weynechen/flickersensor/Doc/flicker_sensor.pdf

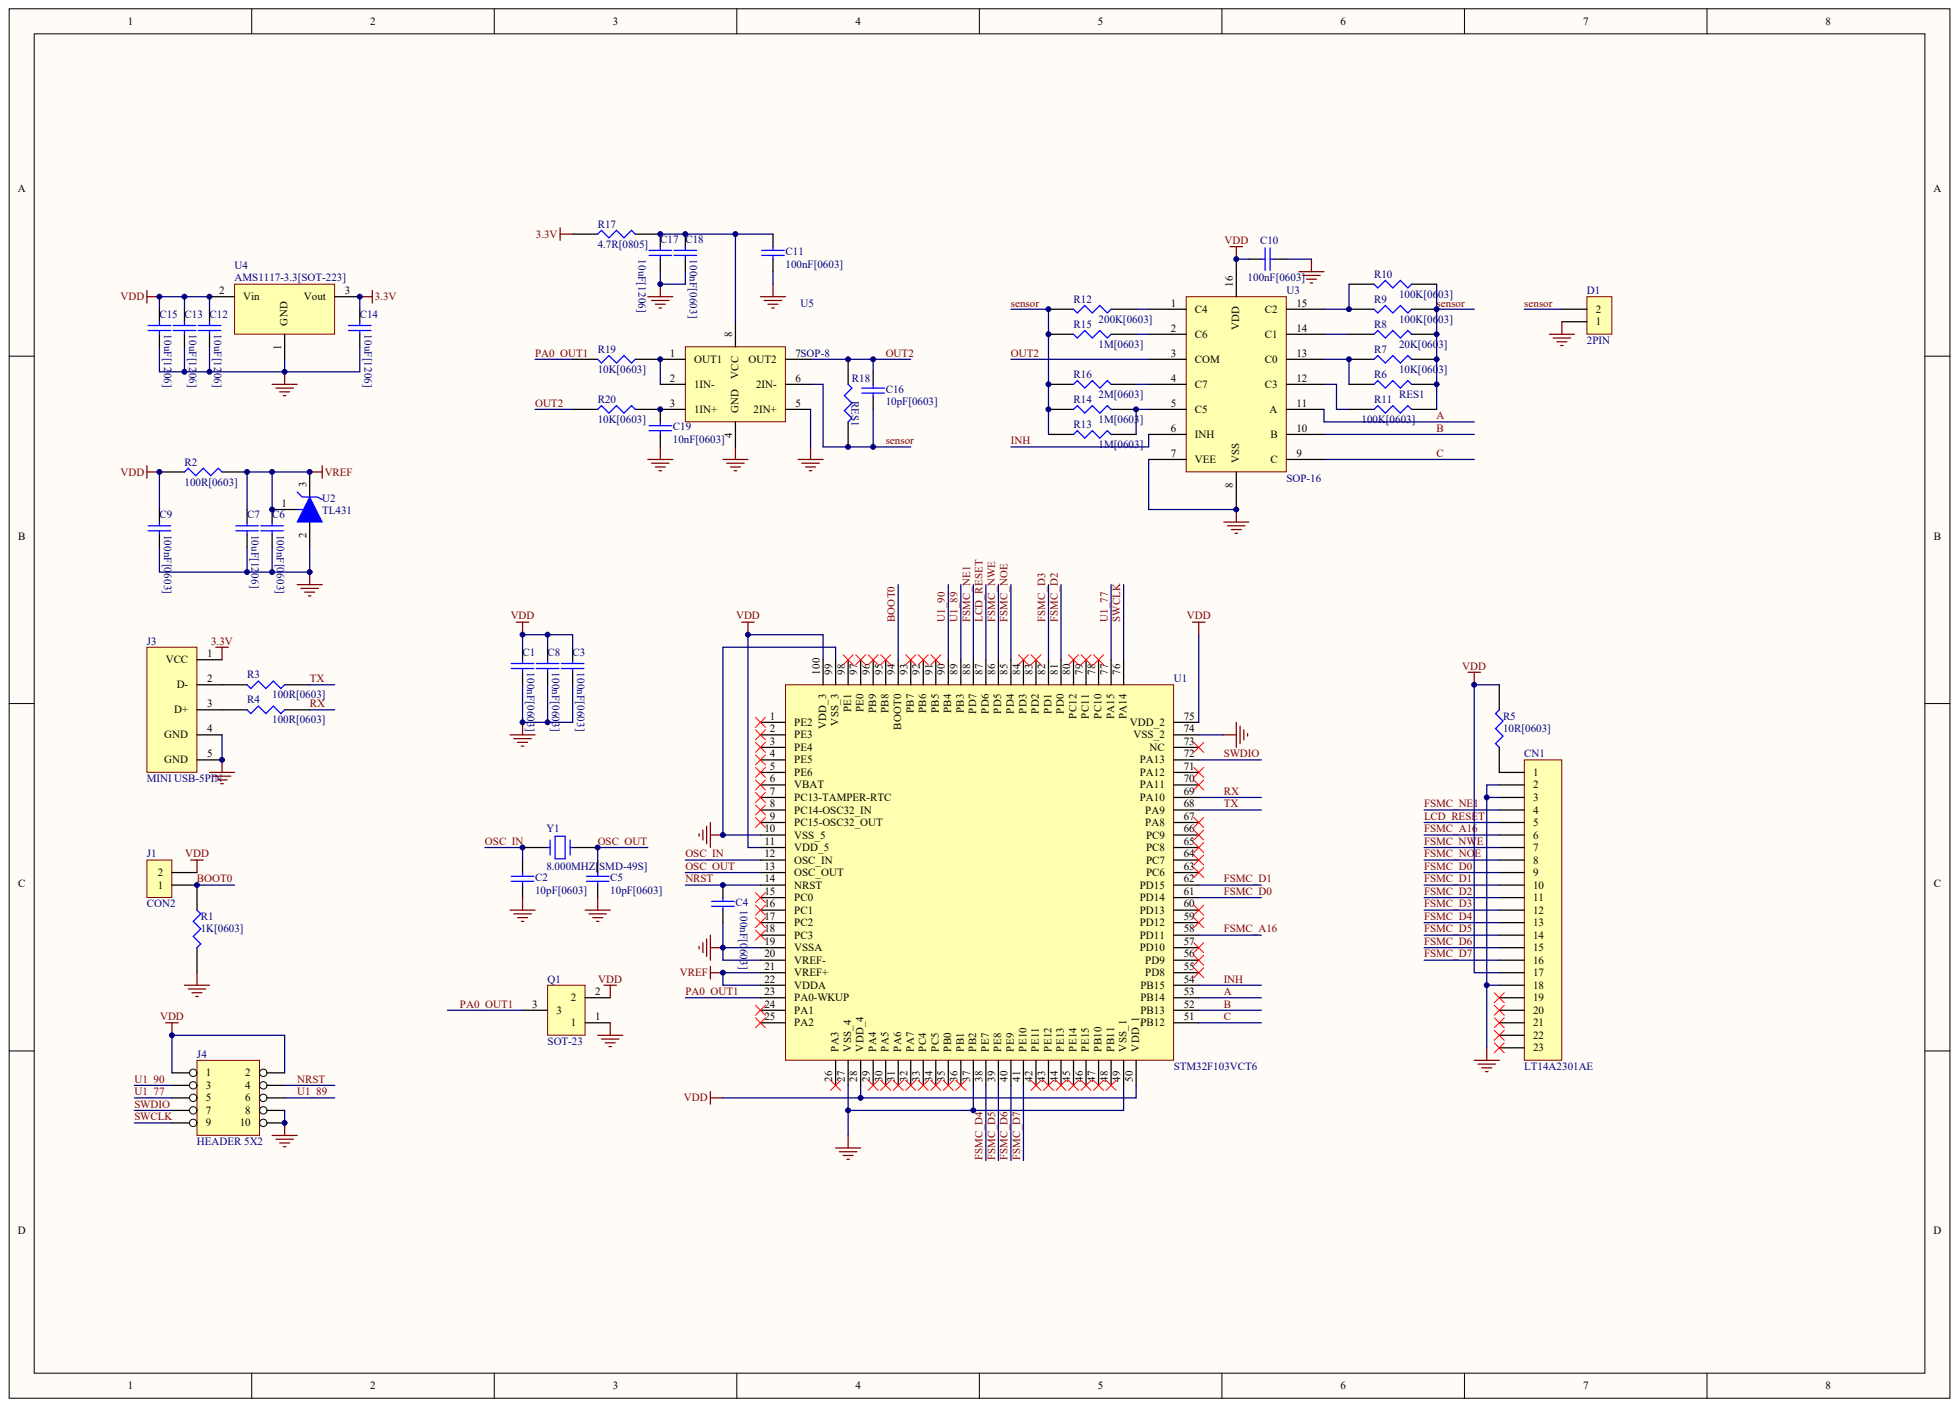
[picture p5: page 1]

INH 1M[0603] | 7
