weynechen/flickersensor/flickersensor_app/Src/main.c

/**
 ******************************************************************************
 * File Name          : main.c
 * Description        : Main program body
 ******************************************************************************
 *
 * COPYRIGHT(c) 2017 STMicroelectronics
 *
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
 ******************************************************************************
 */
/* Includes ------------------------------------------------------------------*/
#include "main.h"
#include "stm32f1xx_hal.h"

/* USER CODE BEGIN Includes */
#include "acquire.h"
#include "sysconfig.h"
#include "flicker.h"
#include "lcd.h"
#include "stdio.h"
#include "string.h"
#include "math.h"
#include "com.h"
/* USER CODE END Includes */

ADC_HandleTypeDef hadc1;
DMA_HandleTypeDef hdma_adc1;

TIM_HandleTypeDef htim1;

UART_HandleTypeDef huart1;
DMA_HandleTypeDef hdma_usart1_rx;

/* USER CODE BEGIN PV */

/* USER CODE END PV */

void SystemClock_Config(void);
void Error_Handler(void);
static void MX_GPIO_Init(void);
static void MX_DMA_Init(void);
static void MX_USART1_UART_Init(void);
static void MX_ADC1_Init(void);
static void MX_TIM1_Init(void);

/* USER CODE BEGIN PFP */
#define  LIGHT_STEEL_BLUE    46651
#define  DEEP_SKY_BLUE       1535
#define  MINERAL_BLUE        627
#define  SKY_BLUE            34429
#define  DARK_CYAN           1105


/* USER CODE END PFP */

/* USER CODE BEGIN 0 */
static uint8_t ChannelIndex = 7;
static uint8_t TimeToSend   = 0;

/* USER CODE END 0 */

int main(void)
{
  /* USER CODE BEGIN 1 */
  char buff[20];
  float flicker_value = 0;
  float last_value    = 1;
  float log_flicker;

  /* USER CODE END 1 */

  /* MCU Configuration----------------------------------------------------------*/

  /* Reset of all peripherals, Initializes the Flash interface and the Systick. */
  HAL_Init();

  /* Configure the system clock */
  SystemClock_Config();

  /* Initialize all configured peripherals */
  MX_GPIO_Init();
  MX_DMA_Init();
  MX_USART1_UART_Init();
  MX_ADC1_Init();
  MX_TIM1_Init();

  /* USER CODE BEGIN 2 */
  LCD_Init();
  BackColor = DARK_CYAN;
  LCD_WriteFull(DARK_CYAN);//0x5D7A

  FontColor = 0xffff;

  LCD_ShowChar2(100, 5, '%');
  LCD_ShowString2(90, 36, "dB");

  FontColor = DEEP_SKY_BLUE;
  LCD_Fill(0, 4);
  LCD_Fill(70, 75);
  LCD_Fill(LCD_YSIZE - 5, LCD_YSIZE);

  FontColor = DARK_CYAN;
  LCD_Fill(76, LCD_YSIZE - 4);

  FontColor = SKY_BLUE;
  LCD_DrawLine(0, 4, LCD_XSIZE, 4);
  LCD_DrawLine(0, 70, LCD_XSIZE, 70);
  LCD_DrawLine(0, 75, LCD_XSIZE, 75);
  LCD_DrawLine(0, LCD_XSIZE - 5, LCD_XSIZE, LCD_XSIZE - 5);

  FontColor = 0xffff;
  LCD_ShowString(4, 79, "VCOM:", 12);
  LCD_ShowString(4, 94, "ID:", 12);
  LCD_ShowString(4, 108, "Times:", 12);

  FontColor = 0xffe0;
  if (CheckSecurity() == false)
  {
    FontColor = BackColor;
    while (1)
    {
    }
  }

  if (HAL_UART_Receive_DMA(&huart1, RXTemp, BUFFER_SIZE) != HAL_OK)
  {
    while (1)
    {
    }
  }

  SelChannel(ChannelIndex);
  AcquireStart();
  /* USER CODE END 2 */

  /* Infinite loop */
  /* USER CODE BEGIN WHILE */
  while (1)
  {
    if (DataReady)
    {
      flicker_value = GetFlickerValue(Buffer0, SAMPLE_SIZE);
      if (flicker_value == (float)OVERFLOW_ERROR)
      {
        if (ChannelIndex != 0)
        {
          ChannelIndex--;
        }
        last_value = flicker_value;
      }
      else if (flicker_value == (float)DC_ERROR)
      {
        if (ChannelIndex != 7)
        {
          ChannelIndex++;
        }
        last_value = flicker_value;
      }
      else
      {
        flicker_value *= 1.3;//calibrate
        if(TimeToSend>1)
        {
          SendFlicker((uint16_t)(flicker_value * 1000));
          TimeToSend = 0;
        }
      }
      SelChannel(ChannelIndex);
      DataReady = 0;
      AcquireStart();
    }
    else if ((flicker_value != last_value)&&(TimeToSend==0))
    {
      uint8_t len;

      last_value = flicker_value;

      memset(buff, 0, sizeof(buff));
      sprintf(buff, "%.1f ", (float)flicker_value * 100);
      len = strlen(buff);
      while (len < 5)
      {
        buff[len++] = ' ';
      }
      LCD_ShowString2(4, 5, (uint8_t *)buff);

      log_flicker = 20 * log10((float)flicker_value);

      memset(buff, 0, sizeof(buff));
      sprintf(buff, "%.1f", log_flicker);
      len = strlen(buff);
      while (len < 5)
      {
        buff[len++] = ' ';
      }
      LCD_ShowString2(4, 36, (uint8_t *)buff);
    }

    if (TaskID != TASK_NULL)
    {
      if (TaskID == FLICKER_VALUE)
      {
        TimeToSend++;
      }
      else
      {
        LCD_ShowString(64, 79, "    ", 12);
        LCD_ShowString(64, 94, "    ", 12);
        LCD_ShowString(64, 108, "    ", 12);
        
        memset(buff, 0, sizeof(buff));
        sprintf(buff, "0x%X", VCOM);
        LCD_ShowString(64, 79, (uint8_t *)buff, 12);
        sprintf(buff, "0x%X", ID);
        LCD_ShowString(64, 94, (uint8_t *)buff, 12);
        sprintf(buff, "%d", Times);
        LCD_ShowString(64, 108, (uint8_t *)buff, 12);
      }
      TaskID = TASK_NULL;
    }
    /* USER CODE END WHILE */

    /* USER CODE BEGIN 3 */
  }
  /* USER CODE END 3 */
}


/** System Clock Configuration
 */
void SystemClock_Config(void)
{
  RCC_OscInitTypeDef RCC_OscInitStruct;
  RCC_ClkInitTypeDef RCC_ClkInitStruct;
  RCC_PeriphCLKInitTypeDef PeriphClkInit;

  /**Initializes the CPU, AHB and APB busses clocks
   */
  RCC_OscInitStruct.OscillatorType = RCC_OSCILLATORTYPE_HSE;
  RCC_OscInitStruct.HSEState       = RCC_HSE_ON;
  RCC_OscInitStruct.HSEPredivValue = RCC_HSE_PREDIV_DIV1;
  RCC_OscInitStruct.HSIState       = RCC_HSI_ON;
  RCC_OscInitStruct.PLL.PLLState   = RCC_PLL_ON;
  RCC_OscInitStruct.PLL.PLLSource  = RCC_PLLSOURCE_HSE;
  RCC_OscInitStruct.PLL.PLLMUL     = RCC_PLL_MUL9;
  if (HAL_RCC_OscConfig(&RCC_OscInitStruct) != HAL_OK)
  {
    Error_Handler();
  }

  /**Initializes the CPU, AHB and APB busses clocks
   */
  RCC_ClkInitStruct.ClockType      = RCC_CLOCKTYPE_HCLK | RCC_CLOCKTYPE_SYSCLK | RCC_CLOCKTYPE_PCLK1 | RCC_CLOCKTYPE_PCLK2;
  RCC_ClkInitStruct.SYSCLKSource   = RCC_SYSCLKSOURCE_PLLCLK;
  RCC_ClkInitStruct.AHBCLKDivider  = RCC_SYSCLK_DIV1;
  RCC_ClkInitStruct.APB1CLKDivider = RCC_HCLK_DIV2;
  RCC_ClkInitStruct.APB2CLKDivider = RCC_HCLK_DIV1;

  if (HAL_RCC_ClockConfig(&RCC_ClkInitStruct, FLASH_LATENCY_2) != HAL_OK)
  {
    Error_Handler();
  }

  PeriphClkInit.PeriphClockSelection = RCC_PERIPHCLK_ADC;
  PeriphClkInit.AdcClockSelection    = RCC_ADCPCLK2_DIV6;
  if (HAL_RCCEx_PeriphCLKConfig(&PeriphClkInit) != HAL_OK)
  {
    Error_Handler();
  }

  /**Configure the Systick interrupt time
   */
  HAL_SYSTICK_Config(HAL_RCC_GetHCLKFreq() / 1000);

  /**Configure the Systick
   */
  HAL_SYSTICK_CLKSourceConfig(SYSTICK_CLKSOURCE_HCLK);

  /* SysTick_IRQn interrupt configuration */
  HAL_NVIC_SetPriority(SysTick_IRQn, 0, 0);
}


/* ADC1 init function */
static void MX_ADC1_Init(void)
{
  ADC_ChannelConfTypeDef sConfig;

  /**Common config
   */
  hadc1.Instance                   = ADC1;
  hadc1.Init.ScanConvMode          = ADC_SCAN_DISABLE;
  hadc1.Init.ContinuousConvMode    = DISABLE;
  hadc1.Init.DiscontinuousConvMode = DISABLE;
  hadc1.Init.ExternalTrigConv      = ADC_EXTERNALTRIGCONV_T1_CC1;
  hadc1.Init.DataAlign             = ADC_DATAALIGN_RIGHT;
  hadc1.Init.NbrOfConversion       = 1;
  if (HAL_ADC_Init(&hadc1) != HAL_OK)
  {
    Error_Handler();
  }

  /**Configure Regular Channel
   */
  sConfig.Channel      = ADC_CHANNEL_0;
  sConfig.Rank         = 1;
  sConfig.SamplingTime = ADC_SAMPLETIME_1CYCLE_5;
  if (HAL_ADC_ConfigChannel(&hadc1, &sConfig) != HAL_OK)
  {
    Error_Handler();
  }
}


/* TIM1 init function */
static void MX_TIM1_Init(void)
{
  TIM_ClockConfigTypeDef sClockSourceConfig;
  TIM_MasterConfigTypeDef sMasterConfig;
  TIM_OC_InitTypeDef sConfigOC;
  TIM_BreakDeadTimeConfigTypeDef sBreakDeadTimeConfig;

  htim1.Instance               = TIM1;
  htim1.Init.Prescaler         = 72 - 1;
  htim1.Init.CounterMode       = TIM_COUNTERMODE_UP;
  htim1.Init.Period            = 1000;
  htim1.Init.ClockDivision     = TIM_CLOCKDIVISION_DIV1;
  htim1.Init.RepetitionCounter = 0;
  if (HAL_TIM_Base_Init(&htim1) != HAL_OK)
  {
    Error_Handler();
  }

  sClockSourceConfig.ClockSource = TIM_CLOCKSOURCE_INTERNAL;
  if (HAL_TIM_ConfigClockSource(&htim1, &sClockSourceConfig) != HAL_OK)
  {
    Error_Handler();
  }

  if (HAL_TIM_OC_Init(&htim1) != HAL_OK)
  {
    Error_Handler();
  }

  sMasterConfig.MasterOutputTrigger = TIM_TRGO_OC1REF;
  sMasterConfig.MasterSlaveMode     = TIM_MASTERSLAVEMODE_DISABLE;
  if (HAL_TIMEx_MasterConfigSynchronization(&htim1, &sMasterConfig) != HAL_OK)
  {
    Error_Handler();
  }

  sConfigOC.OCMode       = TIM_OCMODE_PWM1;
  sConfigOC.Pulse        = 500;
  sConfigOC.OCPolarity   = TIM_OCPOLARITY_HIGH;
  sConfigOC.OCNPolarity  = TIM_OCNPOLARITY_HIGH;
  sConfigOC.OCFastMode   = TIM_OCFAST_DISABLE;
  sConfigOC.OCIdleState  = TIM_OCIDLESTATE_RESET;
  sConfigOC.OCNIdleState = TIM_OCNIDLESTATE_RESET;
  if (HAL_TIM_OC_ConfigChannel(&htim1, &sConfigOC, TIM_CHANNEL_1) != HAL_OK)
  {
    Error_Handler();
  }

  sBreakDeadTimeConfig.OffStateRunMode  = TIM_OSSR_DISABLE;
  sBreakDeadTimeConfig.OffStateIDLEMode = TIM_OSSI_DISABLE;
  sBreakDeadTimeConfig.LockLevel        = TIM_LOCKLEVEL_OFF;
  sBreakDeadTimeConfig.DeadTime         = 0;
  sBreakDeadTimeConfig.BreakState       = TIM_BREAK_DISABLE;
  sBreakDeadTimeConfig.BreakPolarity    = TIM_BREAKPOLARITY_HIGH;
  sBreakDeadTimeConfig.AutomaticOutput  = TIM_AUTOMATICOUTPUT_DISABLE;
  if (HAL_TIMEx_ConfigBreakDeadTime(&htim1, &sBreakDeadTimeConfig) != HAL_OK)
  {
    Error_Handler();
  }
}


/* USART1 init function */
static void MX_USART1_UART_Init(void)
{
  huart1.Instance          = USART1;
  huart1.Init.BaudRate     = 115200;
  huart1.Init.WordLength   = UART_WORDLENGTH_8B;
  huart1.Init.StopBits     = UART_STOPBITS_1;
  huart1.Init.Parity       = UART_PARITY_NONE;
  huart1.Init.Mode         = UART_MODE_TX_RX;
  huart1.Init.HwFlowCtl    = UART_HWCONTROL_NONE;
  huart1.Init.OverSampling = UART_OVERSAMPLING_16;
  if (HAL_UART_Init(&huart1) != HAL_OK)
  {
    Error_Handler();
  }
}


/**
 * Enable DMA controller clock
 */
static void MX_DMA_Init(void)
{
  /* DMA controller clock enable */
  __HAL_RCC_DMA1_CLK_ENABLE();

  /* DMA interrupt init */
  /* DMA1_Channel1_IRQn interrupt configuration */
  HAL_NVIC_SetPriority(DMA1_Channel1_IRQn, 0, 0);
  HAL_NVIC_EnableIRQ(DMA1_Channel1_IRQn);
  /* DMA1_Channel5_IRQn interrupt configuration */
  HAL_NVIC_SetPriority(DMA1_Channel5_IRQn, 2, 0);
  HAL_NVIC_EnableIRQ(DMA1_Channel5_IRQn);
}


/** Configure pins as
 * Analog
 * Input
 * Output
 * EVENT_OUT
 * EXTI
 */
static void MX_GPIO_Init(void)
{
  GPIO_InitTypeDef GPIO_InitStruct;

  /* GPIO Ports Clock Enable */
  __HAL_RCC_GPIOA_CLK_ENABLE();
  __HAL_RCC_GPIOE_CLK_ENABLE();
  __HAL_RCC_GPIOB_CLK_ENABLE();
  __HAL_RCC_GPIOD_CLK_ENABLE();
  __HAL_RCC_GPIOC_CLK_ENABLE();

  /*Configure GPIO pin Output Level */
  HAL_GPIO_WritePin(GPIOE, S0_Pin | S1_Pin | S2_Pin | OE_Pin, GPIO_PIN_RESET);

  /*Configure GPIO pin Output Level */
  HAL_GPIO_WritePin(GPIOB, CS_Pin | RESET_Pin | RS_Pin | WR_Pin, GPIO_PIN_RESET);

  /*Configure GPIO pin Output Level */
  HAL_GPIO_WritePin(GPIOD, D0_Pin | D1_Pin | D2_Pin | D3_Pin | D4_Pin | D5_Pin | D6_Pin, GPIO_PIN_RESET);

  /*Configure GPIO pin Output Level */
  HAL_GPIO_WritePin(GPIOC, D7_Pin | SPI_LANE_SEL_Pin | S_P_Pin, GPIO_PIN_RESET);

  /*Configure GPIO pins : S0_Pin S1_Pin S2_Pin OE_Pin */
  GPIO_InitStruct.Pin   = S0_Pin | S1_Pin | S2_Pin | OE_Pin;
  GPIO_InitStruct.Mode  = GPIO_MODE_OUTPUT_PP;
  GPIO_InitStruct.Speed = GPIO_SPEED_FREQ_LOW;
  HAL_GPIO_Init(GPIOE, &GPIO_InitStruct);

  /*Configure GPIO pins : CS_Pin RESET_Pin RS_Pin WR_Pin */
  GPIO_InitStruct.Pin   = CS_Pin | RESET_Pin | RS_Pin | WR_Pin;
  GPIO_InitStruct.Mode  = GPIO_MODE_OUTPUT_PP;
  GPIO_InitStruct.Speed = GPIO_SPEED_FREQ_HIGH;
  HAL_GPIO_Init(GPIOB, &GPIO_InitStruct);

  /*Configure GPIO pin : RD_Pin */
  // GPIO_InitStruct.Pin = RD_Pin;
  // GPIO_InitStruct.Mode = GPIO_MODE_INPUT;
  // GPIO_InitStruct.Pull = GPIO_PULLUP;
  // HAL_GPIO_Init(RD_GPIO_Port, &GPIO_InitStruct);

  /*Configure GPIO pins : D0_Pin D1_Pin D2_Pin D3_Pin
   *                       D4_Pin D5_Pin D6_Pin */
  GPIO_InitStruct.Pin   = D0_Pin | D1_Pin | D2_Pin | D3_Pin | D4_Pin | D5_Pin | D6_Pin | RD_Pin;
  GPIO_InitStruct.Mode  = GPIO_MODE_OUTPUT_PP;
  GPIO_InitStruct.Speed = GPIO_SPEED_FREQ_HIGH;
  HAL_GPIO_Init(GPIOD, &GPIO_InitStruct);

  /*Configure GPIO pins : D7_Pin SPI_LANE_SEL_Pin S_P_Pin */
  GPIO_InitStruct.Pin   = D7_Pin | SPI_LANE_SEL_Pin | S_P_Pin;
  GPIO_InitStruct.Mode  = GPIO_MODE_OUTPUT_PP;
  GPIO_InitStruct.Speed = GPIO_SPEED_FREQ_HIGH;
  HAL_GPIO_Init(GPIOC, &GPIO_InitStruct);
}


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
