weynechen/flickersensor/flickersensor_app/flickersensor.ioc

Mcu.UserName=STM32F103VCTx
PA0-WKUP.Signal=ADCx_IN0
PA10.Signal=USART1_RX
PA13.Signal=SYS_JTMS-SWDIO
PA14.Signal=SYS_JTCK-SWCLK
PA8.Signal=S_TIM1_CH1
PA9.Signal=USART1_TX
PB12.GPIO_Label=CS
PB12.Signal=GPIO_Output
PB13.GPIO_Label=RESET
PB13.Signal=GPIO_Output
PB14.GPIO_Label=RS
PB14.Signal=GPIO_Output
PB15.GPIO_Label=WR
PB15.Signal=GPIO_Output
PC6.GPIO_Label=D7
PC6.Signal=GPIO_Output
PC7.GPIO_Label=SPI_LANE_SEL
PC7.Signal=GPIO_Output
PC9.GPIO_Label=S_P
PC9.Signal=GPIO_Output
PD10.GPIO_Label=D1
PD10.Signal=GPIO_Output
PD11.GPIO_Label=D2
PD11.Signal=GPIO_Output
PD12.GPIO_Label=D3
PD12.Signal=GPIO_Output
PD13.GPIO_Label=D4
PD13.Signal=GPIO_Output
PD14.GPIO_Label=D5
PD14.Signal=GPIO_Output
PD15.GPIO_Label=D6
PD15.Signal=GPIO_Output
PD8.GPIO_Label=RD
PD8.Signal=GPIO_Input
PD9.GPIO_Label=D0
PD9.Signal=GPIO_Output
PE10.GPIO_Label=S0
PE10.Signal=GPIO_Output
PE11.GPIO_Label=S1
PE11.Signal=GPIO_Output
PE12.GPIO_Label=S2
PE12.Signal=GPIO_Output
PE13.GPIO_Label=OE
PE13.Signal=GPIO_Output
