weynechen/flickersensor/flickersensor_app/Bsp/bg.c

#include "flash_if.h"
const unsigned char __attribute__((at(ADDR_FLASH_PAGE_66))) BgArray[32768] =   /* 0X00,0X10,0X80,0X00,0X80,0X00,0X01,0X1B, */
{
  0X5D, 0X7A, 0X5D, 0X7A, 0X5D, 0X7A, 0X5D, 0X7A, 0X5D, 0X7A, 0X5D, 0X7A, 0X5D, 0X7A, 0X5D, 0X7A,
  0X5D, 0X7A, 0X5D, 0X7A, 0X5D, 0X7A, 0X5D, 0X7A, 0X5D, 0X7A, 0X5D, 0X7A, 0X5D, 0X7A, 0X5D, 0X7A,
  0X5D, 0X7A, 0X5D, 0X7A, 0X5D, 0X7A, 0X5D, 0X7A, 0X5D, 0X7A, 0X5D, 0X7A, 0X5D, 0X7A, 0X5D, 0X7A,
  0X5D, 0X7A, 0X5D, 0X7A, 0X5D, 0X7A, 0X5D, 0X7A, 0X5D, 0X7A, 0X5D, 0X7A, 0X5D, 0X7A, 0X5D, 0X7A,
  0X5D, 0X7A, 0X5D, 0X7A, 0X5D, 0X7A, 0X5D, 0X7A, 0X5D, 0X7A, 0X5D, 0X7A, 0X5D, 0X7A, 0X5D, 0X7A,
  0X5D, 0X7A, 0X5D, 0X7A, 0X5D, 0X7A, 0X5D, 0X7A, 0X5D, 0X7A, 0X5D, 0X7A, 0X5D, 0X7A, 0X5D, 0X7A,
  0X5D, 0X7A, 0X5D, 0X7A, 0X5D, 0X7A, 0X5D, 0X7A, 0X5D, 0X7A, 0X5D, 0X7A, 0X5D, 0X7A, 0X5D, 0X7A,
  0X5D, 0X7A, 0X5D, 0X7A, 0X5D, 0X7A, 0X5D, 0X7A, 0X5D, 0X7A, 0X5D, 0X7A, 0X5D, 0X7A, 0X5D, 0X7A,
  0X5D, 0X7A, 0X5D, 0X7A, 0X5D, 0X7A, 0X5D, 0X7A, 0X5D, 0X7A, 0X5D, 0X7A, 0X5D, 0X7A, 0X5D, 0X7A,
  0X5D, 0X7A, 0X5D, 0X7A, 0X5D, 0X7A, 0X5D, 0X7A, 0X5D, 0X7A, 0X5D, 0X7A, 0X5D, 0X7A, 0X5D, 0X7A,
  0X5D, 0X7A, 0X5D, 0X7A, 0X5D, 0X7A, 0X5D, 0X7A, 0X5D, 0X7A, 0X5D, 0X7A, 0X5D, 0X7A, 0X5D, 0X7A,
  0X5D, 0X7A, 0X5D, 0X7A, 0X5D, 0X7A, 0X5D, 0X7A, 0X5D, 0X7A, 0X5D, 0X7A, 0X5D, 0X7A, 0X5D, 0X7A,
  0X5D, 0X7A, 0X5D, 0X7A, 0X5D, 0X7A, 0X5D, 0X7A, 0X5D, 0X7A, 0X5D, 0X7A, 0X5D, 0X7A, 0X5D, 0X7A,
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
  0X2B, 0XD4, 0X2B, 0XD4, 0X2B, 0XD4, 0X2B, 0XD4, 0X2B, 0XD4, 0X2B, 0XD4, 0X2B, 0XD4, 0X2B, 0XD4,
  0X2B, 0XD4, 0X2B, 0XD4, 0X2B, 0XD4, 0X2B, 0XD4, 0X2B, 0XD4, 0X2B, 0XD4, 0X2B, 0XD4, 0X2B, 0XD4,
  0X2B, 0XD4, 0X2B, 0XD4, 0X2B, 0XD4, 0X2B, 0XD4, 0X2B, 0XD4, 0X2B, 0XD4, 0X2B, 0XD4, 0X2B, 0XD4,
};
