weynechen/flickersensor/(commit log)

2017-05-15 初次建立
2017-05-16 完成ADC采样
2017-05-17 添加新文件
2017-05-17 添加算法
2017-05-17 初步测试通过
2017-05-31 加入通讯协议设计
2017-06-12 完成LCD驱动，花屏
2017-06-19 屏已正常点亮
2017-06-20 已可以正常显示字符
2017-06-20 正常显示flicker,vcom,id
2017-06-25 加入发送flicker 功能
2017-06-25 调整代码格式
2017-07-23 加入自适应
2017-07-23 考虑硅光电池饱和的情况
2017-07-30 加入双向通讯
2017-08-01 加入显示vcom和ID的功能
2017-08-05 加入校准和主从模式发送
2017-08-14 采样间隔由5ms改成1ms
2017-11-05 完成加密
2017-11-05 修改字体
2017-11-05 修改配色
2017-11-05 加快刷新速度
2017-11-07 更新DB计算方法
2017-11-12 字符调到同一行
2017-11-12 修改上下限
2017-11-26 修复发送上一次flk的bug
2017-11-28 加入字符清除
2017-11-30 略微加快刷屏速度
