weynechen/flickersensor/(notices)

Notices in the files:
flickersensor_app/Src/main.c:
(C) COPYRIGHT STMicroelectronics *****END OF FILE
